aaron-lucas/NumpadPCB/Numpad.kicad_pcb

## KiCad design Numpad.kicad_pcb (2021-01-16)

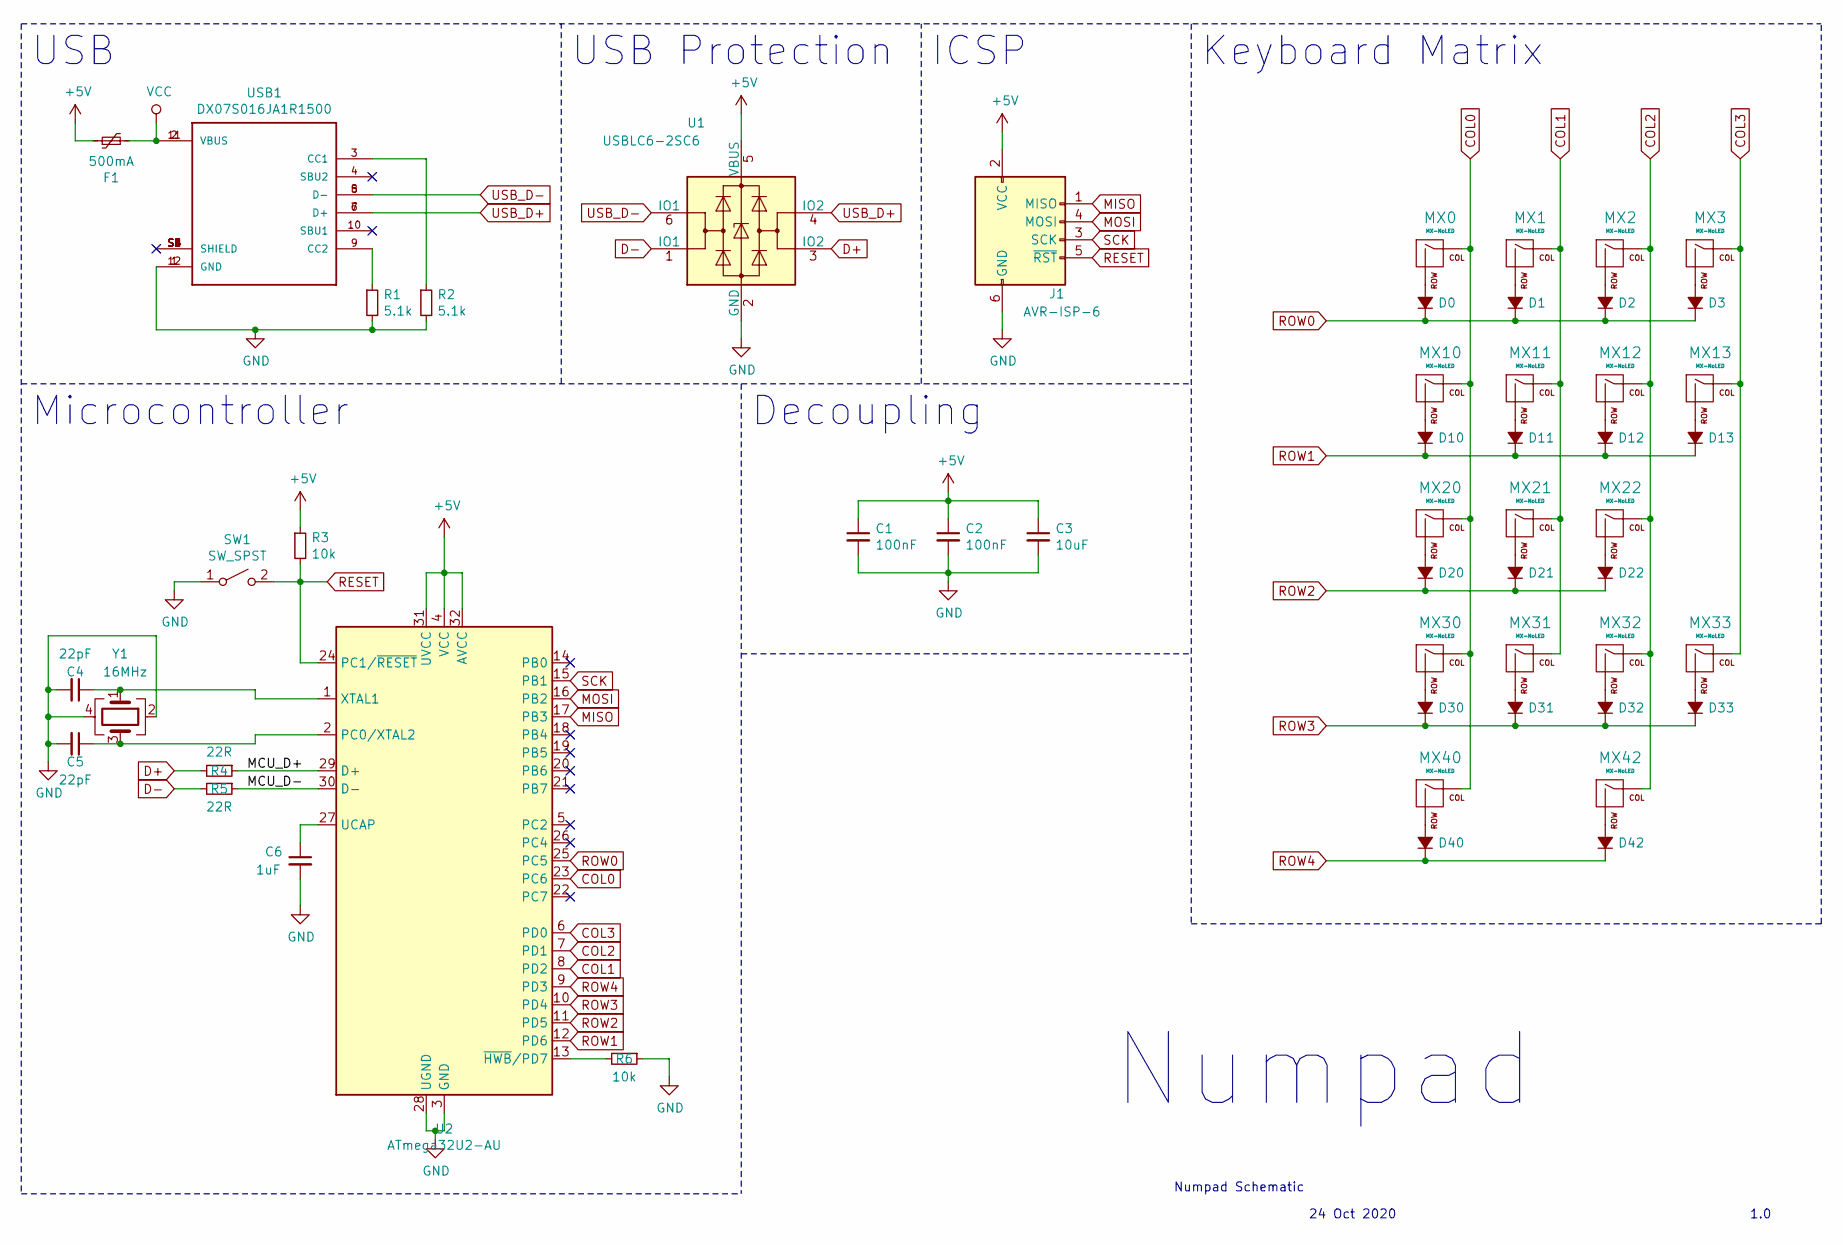
[picture p1: schematic Numpad.sch]

Parts:
C1, C2: 100nF; C_0603_1608Metric; LCSC C1525
C3: 10uF; C_0603_1608Metric; LCSC C19702
C4, C5: 22pF; C_0603_1608Metric; LCSC C1555
C6: 1uF; C_0603_1608Metric; LCSC C52923
D0, D1, D2, D3, D10, D11, D12, D13, D20, D21, D22, D30, D31, D32, D33, D40, D42: D_Small_ALT; D_SOD-123; LCSC C183407
F1: 500mA; Fuse_0603_1608Metric; LCSC C261937
J1: AVR-ISP-6; PinHeader_2x03_P2.54mm_Vertical
MX0, MX1, MX2, MX3, MX10, MX11, MX12, MX20, MX21, MX22, MX30, MX31, MX32, MX42: MX-NoLED; MXOnly-1U-NoLED
MX13, MX33, MX40: MX-NoLED; MXOnly-2U-ReversedStabilizers-NoLED
R1, R2: 5.1k; R_0603_1608Metric; LCSC C25905
R3, R6: 10k; R_0603_1608Metric; LCSC C25744
R4, R5: 22R; R_0603_1608Metric; LCSC C25092
SW1: SW_SPST; TACTILE_SWITCH_SPST_SMD_5.2MM
U1: USBLC6-2SC6; SOT-23-6; LCSC C7519
U2: ATmega32U2-AU; TQFP-32_7x7mm_P0.8mm
USB1: DX07S016JA1R1500; JAE_DX07S016JA1R1500
Y1: 16MHz; Crystal_SMD_3225-4Pin_3.2x2.5mm; LCSC C13738

Connections:
+5V: C1.1, C2.1, C3.1, F1.1, J1.2 (VCC), R3.1, U1.5 (VBUS), U2.4 (VCC), U2.31 (UVCC), U2.32 (AVCC); also elsewhere on the board
/MCU_D+: R4.1, U2.29 (D+)
/MCU_D-: R5.1, U2.30 (D-)
COL0: MX0.1 (COL), MX10.1 (COL), MX20.1 (COL), MX30.1 (COL), MX40.1 (COL), U2.23 (PC6)
COL1: MX1.1 (COL), MX11.1 (COL), MX21.1 (COL), MX31.1 (COL), U2.8 (PD2)
COL2: MX2.1 (COL), MX12.1 (COL), MX22.1 (COL), MX32.1 (COL), MX42.1 (COL), U2.7 (PD1)
COL3: MX3.1 (COL), MX13.1 (COL), MX33.1 (COL), U2.6 (PD0)
D+: R4.2, U1.3 (IO2)
D-: R5.2, U1.1 (IO1)
GND: C1.2, C2.2, C3.2, C4.2, C5.2, C6.2, J1.6 (GND), R1.2, R2.2, R6.1, SW1.1 (A), U1.2 (GND), U2.3 (GND), U2.28 (UGND), USB1.1 (GND), USB1.12 (GND), Y1.2, Y1.4; also elsewhere on the board
MISO: J1.1 (MISO), U2.17 (PB3); also elsewhere on the board
MOSI: J1.4 (MOSI), U2.16 (PB2); also elsewhere on the board
unnamed: C4.1, U2.1 (XTAL1), Y1.1
unnamed: C5.1, U2.2 (PC0/XTAL2), Y1.3
unnamed: C6.1, U2.27 (UCAP)
unnamed: D0.2 (A), MX0.2 (ROW)
unnamed: D1.2 (A), MX1.2 (ROW)
unnamed: D2.2 (A), MX2.2 (ROW)
unnamed: D3.2 (A), MX3.2 (ROW)
unnamed: D10.2 (A), MX10.2 (ROW)
unnamed: D11.2 (A), MX11.2 (ROW)
unnamed: D12.2 (A), MX12.2 (ROW)
unnamed: D13.2 (A), MX13.2 (ROW)
unnamed: D20.2 (A), MX20.2 (ROW)
unnamed: D21.2 (A), MX21.2 (ROW)
unnamed: D22.2 (A), MX22.2 (ROW)
unnamed: D30.2 (A), MX30.2 (ROW)
unnamed: D31.2 (A), MX31.2 (ROW)
unnamed: D32.2 (A), MX32.2 (ROW)
unnamed: D33.2 (A), MX33.2 (ROW)
unnamed: D40.2 (A), MX40.2 (ROW)
unnamed: D42.2 (A), MX42.2 (ROW)
unnamed: R1.1, USB1.9 (CC2)
unnamed: R2.1, USB1.3 (CC1)
unnamed: R6.2, U2.13 (~HWB~/PD7)
unnamed: USB1.S1 (SHIELD), USB1.S2 (SHIELD), USB1.S3 (SHIELD), USB1.S4 (SHIELD), USB1.S5 (SHIELD), USB1.S6 (SHIELD)
RESET: J1.5 (~RST), R3.2, SW1.2 (B), U2.24 (PC1/~RESET); also elsewhere on the board
ROW0: D0.1 (K), D1.1 (K), D2.1 (K), D3.1 (K), U2.25 (PC5)
ROW1: D10.1 (K), D11.1 (K), D12.1 (K), D13.1 (K), U2.12 (PD6)
ROW2: D20.1 (K), D21.1 (K), D22.1 (K), U2.11 (PD5)
ROW3: D30.1 (K), D31.1 (K), D32.1 (K), D33.1 (K), U2.10 (PD4)
ROW4: D40.1 (K), D42.1 (K), U2.9 (PD3)
SCK: J1.3 (SCK), U2.15 (PB1); also elsewhere on the board
USB_D+: U1.4 (IO2), USB1.6 (D+), USB1.7 (D+)
USB_D-: U1.6 (IO1), USB1.5 (D-), USB1.8 (D-)
VCC: F1.2, USB1.2 (VBUS), USB1.11 (VBUS)

Notes on the sheet:
Numpad
Numpad Schematic
24 Oct 2020
1.0
Microcontroller
USB
USB Protection
ICSP
Decoupling
Keyboard Matrix

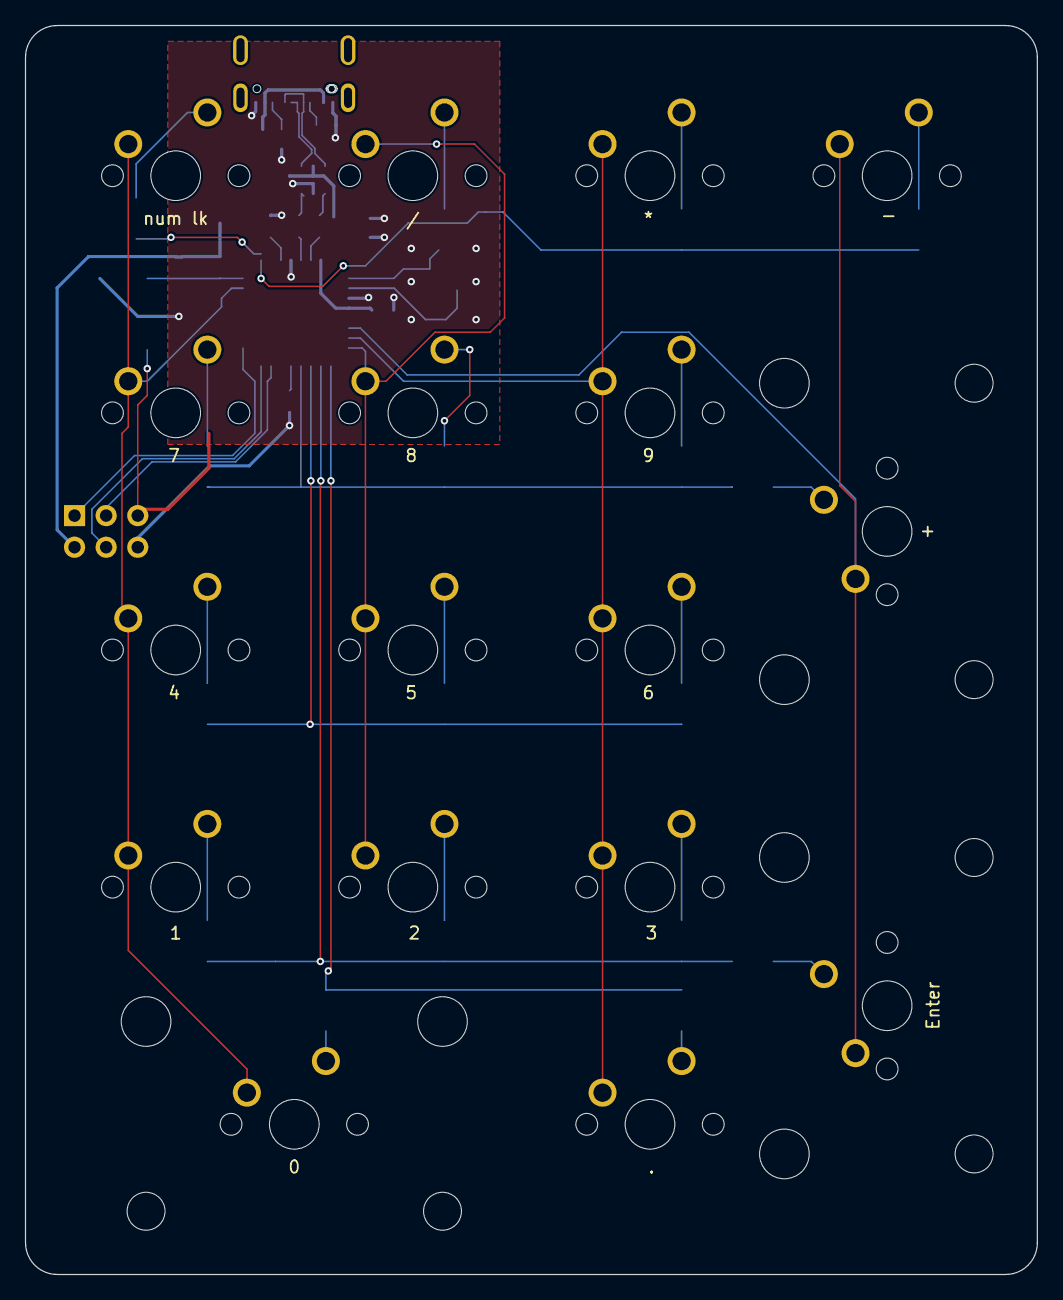
[picture p2: board Numpad.kicad_pcb from above]

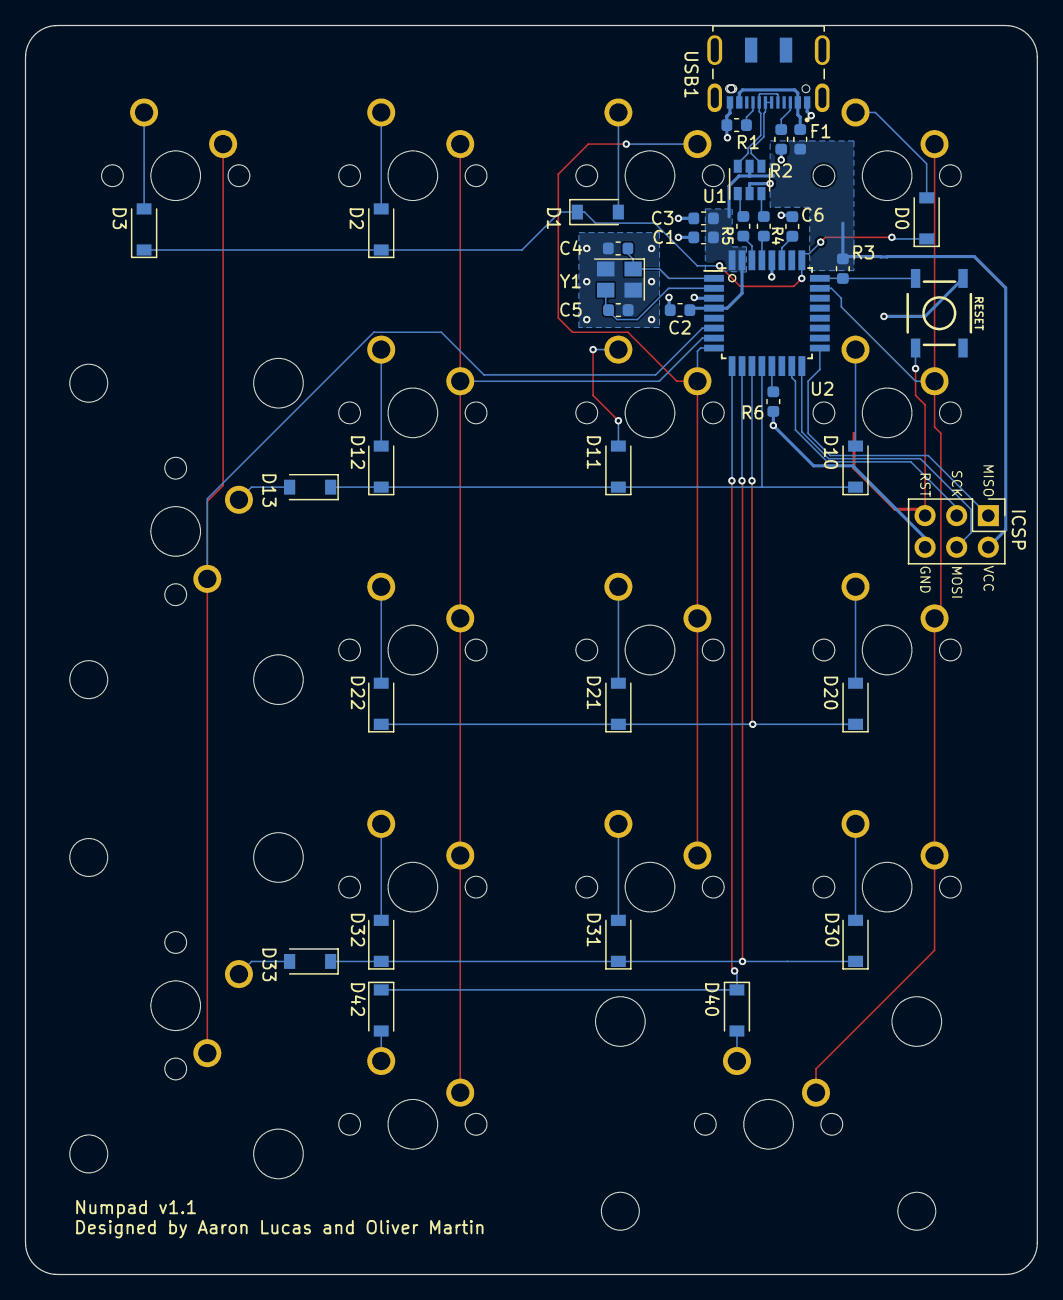
[picture p3: board Numpad.kicad_pcb from below]

Board: 2 copper layers, 81.3 x 100.3 mm, 53 parts (36 on the bottom side), 46 nets.

Other parts of the board:
ICSP: AVR-ISP-6; PinHeader_2x03_P2.54mm_Vertical
RESET: SW_SPST; TACTILE_SWITCH_SPST_SMD_5.2MM

Their connections:
+5V: ICSP.2; also elsewhere on the board
GND: ICSP.6, RESET.1; also elsewhere on the board
MISO: ICSP.1; also elsewhere on the board
MOSI: ICSP.4; also elsewhere on the board
RESET: ICSP.5, RESET.2; also elsewhere on the board
SCK: ICSP.3; also elsewhere on the board
