aaron-lucas/NumpadPCB/(commit log)

2020-08-26 Project setup
    [Numpad.kicad_pcb, Numpad.sch]
2020-08-26 Complete Schematic
2020-08-26 Save progress
    [Numpad.kicad_pcb, Numpad.sch]
2020-08-28 Adjust schematic layout
2020-10-22 Commit all files before starting from scratch
    [Numpad.kicad_pcb, Numpad.sch]
2020-10-22 Restart project
    [Numpad.kicad_pcb, Numpad.sch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]
2020-10-24 Complete PCB v1
    [Numpad-B_Cu.gbl, Numpad-B_Mask.gbs, Numpad-B_SilkS.gbo, Numpad-Edge_Cuts.gm1, Numpad-F_Cu.gtl, Numpad-F_Mask.gts, Numpad-F_SilkS.gto, Numpad.drl]
2021-01-16 Fix issues with reset button and bootloader mode
    [Numpad-B_Cu.gbl, Numpad-B_Mask.gbs, Numpad-B_SilkS.gbo, Numpad-Edge_Cuts.gm1, Numpad-F_Cu.gtl, Numpad-F_Mask.gts, Numpad-F_SilkS.gto, Numpad-bottom-pos.csv]
